gustavmpettersson/StepperPlatform/README.md

# StepperPlatform

This project considers a platform for moving microscopy samples. It is made as a Bachelor's thesis project at KTH. Usage instructions, drawings, and parts can be found in appendices.pdf

Contact me at gupet@kth.se or gustavpettersson@live.com
