gustavmpettersson/StepperPlatform/Drawings/base plate.png

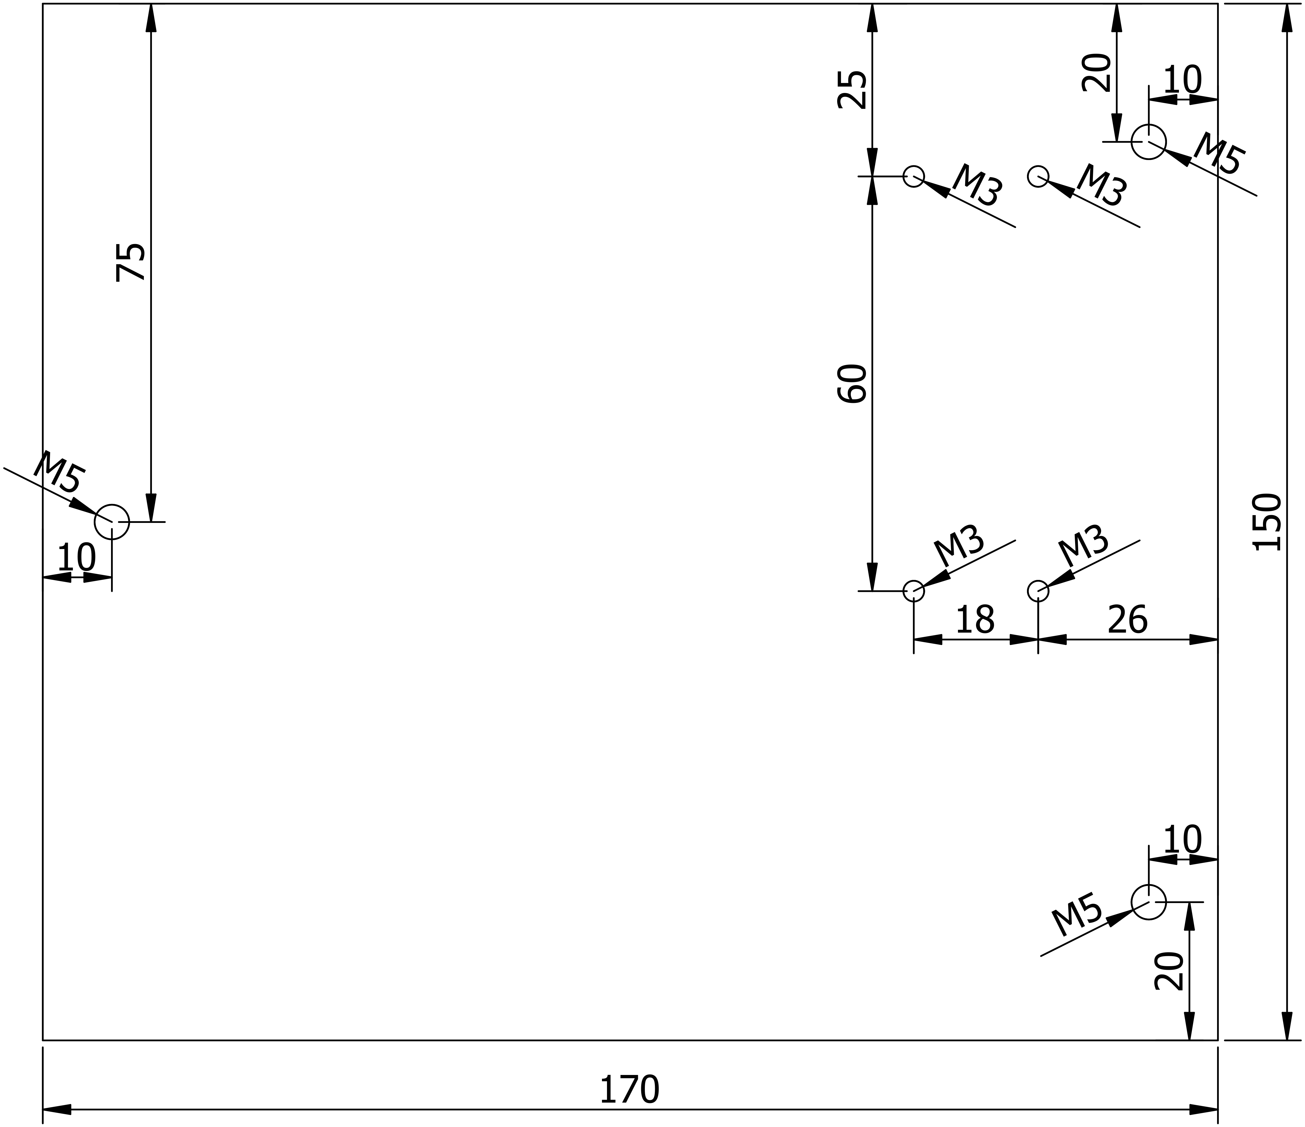
Drawings/base plate.png
