gustavmpettersson/StepperPlatform/Drawings/switch bracket.png

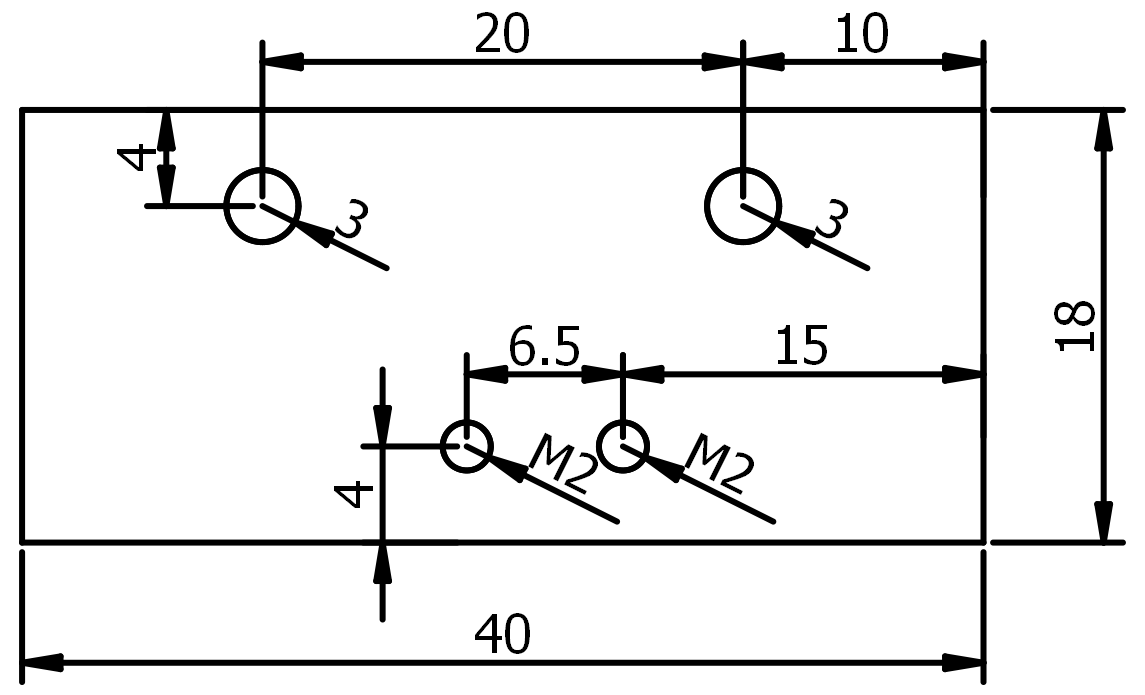
Drawings/switch bracket.png
