gustavmpettersson/StepperPlatform/Drawings/switch bracket.dxf

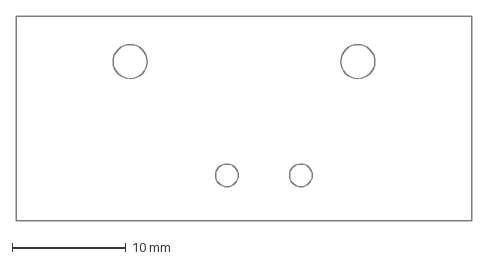
[picture p6: CAD file, 2016-05-02]
Drawings/switch bracket.dxf
40.0 x 18.0 mm
