gustavmpettersson/StepperPlatform/Drawings/base plate.dxf

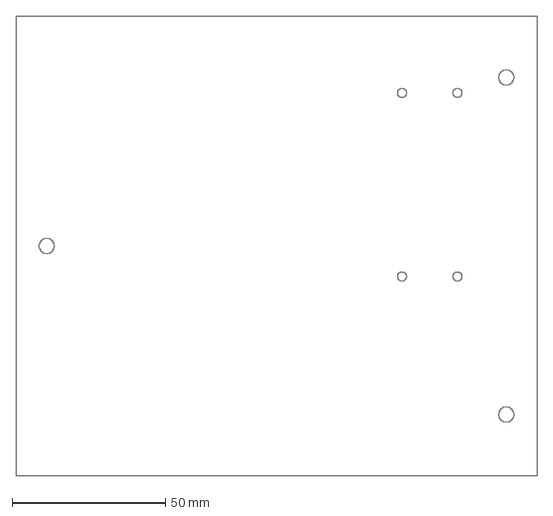
[picture p7: CAD file, 2016-05-02]
Drawings/base plate.dxf
170.0 x 150.0 mm
