gustavmpettersson/StepperPlatform/Drawings/middle bracket.dxf

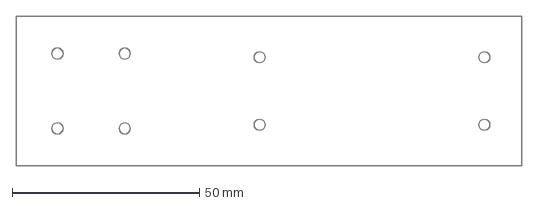
[picture p8: CAD file, 2016-05-02]
Drawings/middle bracket.dxf
135.0 x 40.0 mm
