gustavmpettersson/StepperPlatform/Drawings/sample holder.dxf

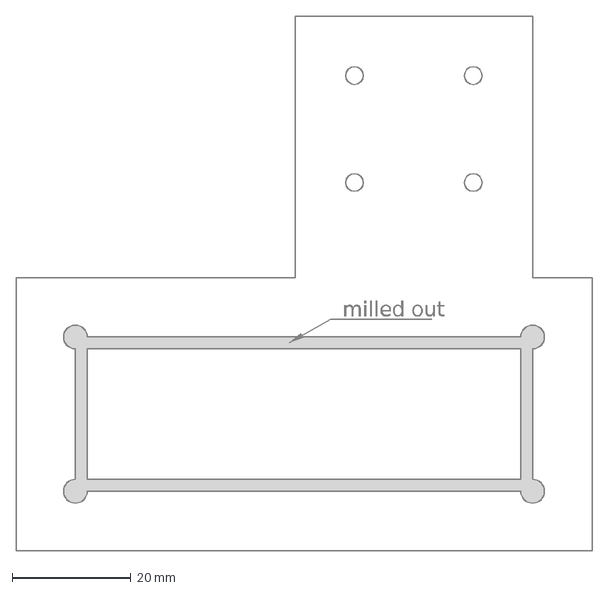
[picture p9: CAD file, 2016-05-02]
Drawings/sample holder.dxf
milled out
