gustavmpettersson/StepperPlatform/Board/KEX V1.brd

## EAGLE design Board/KEX V1.brd (2016-04-30)

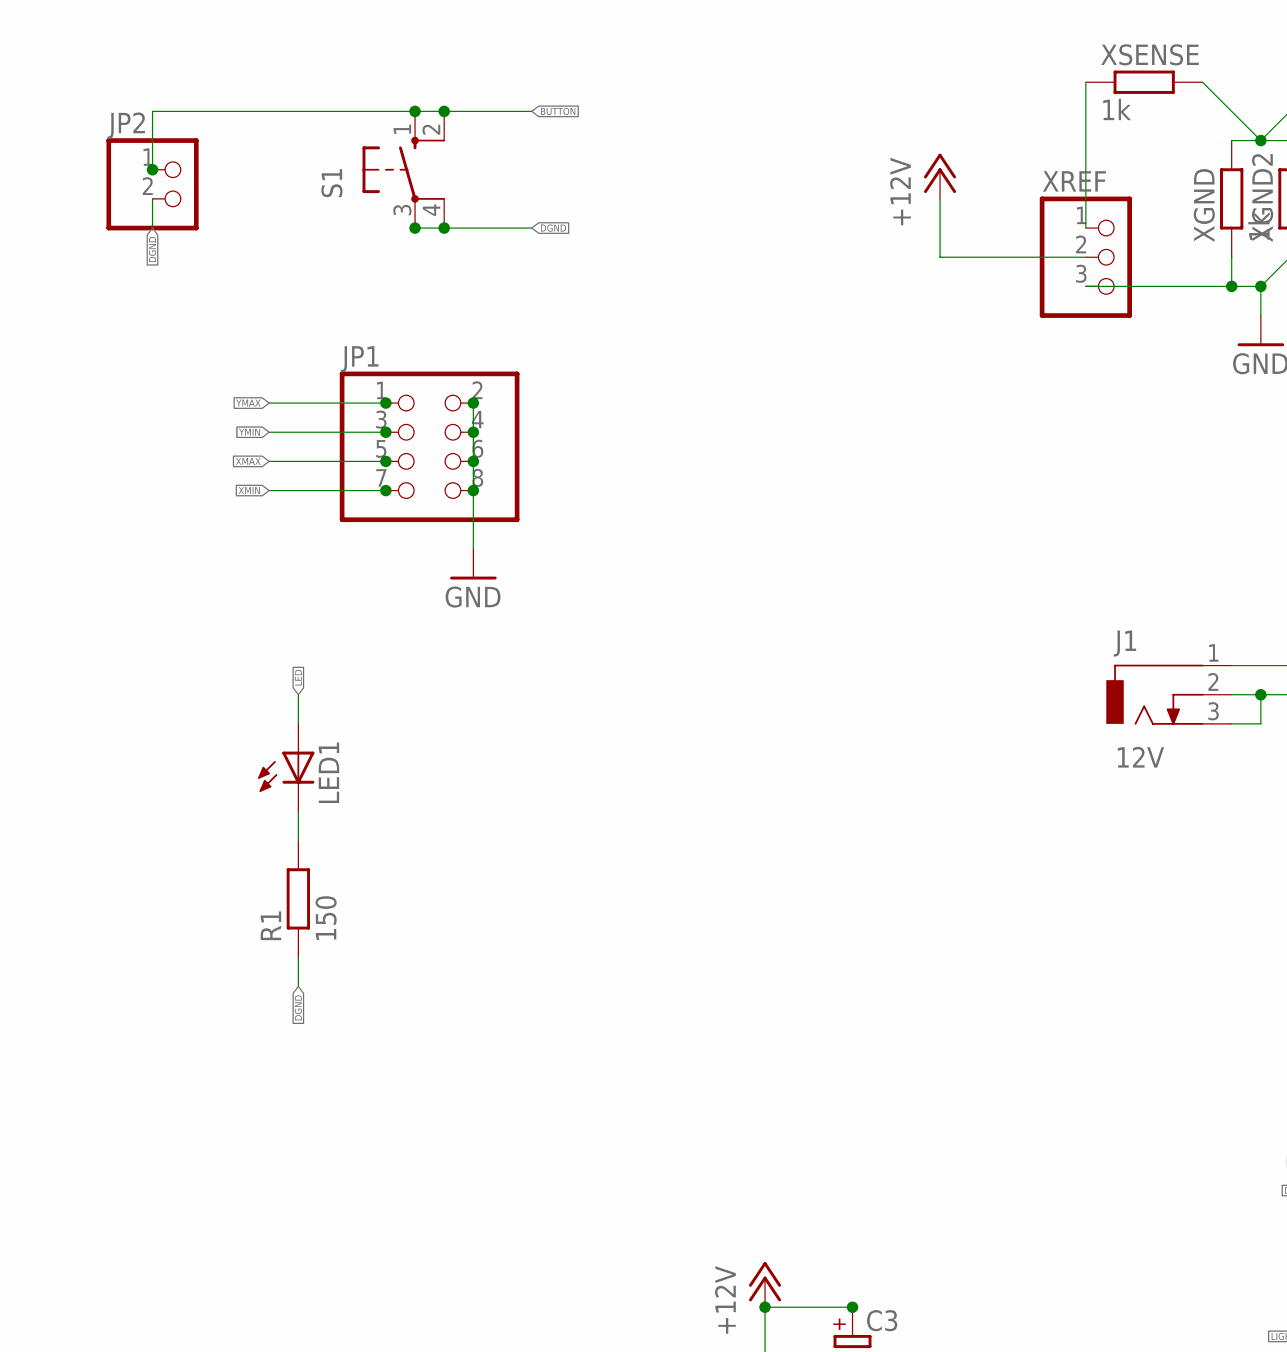
[picture p10: schematic KEX V1.sch, part in row 1, column 1]

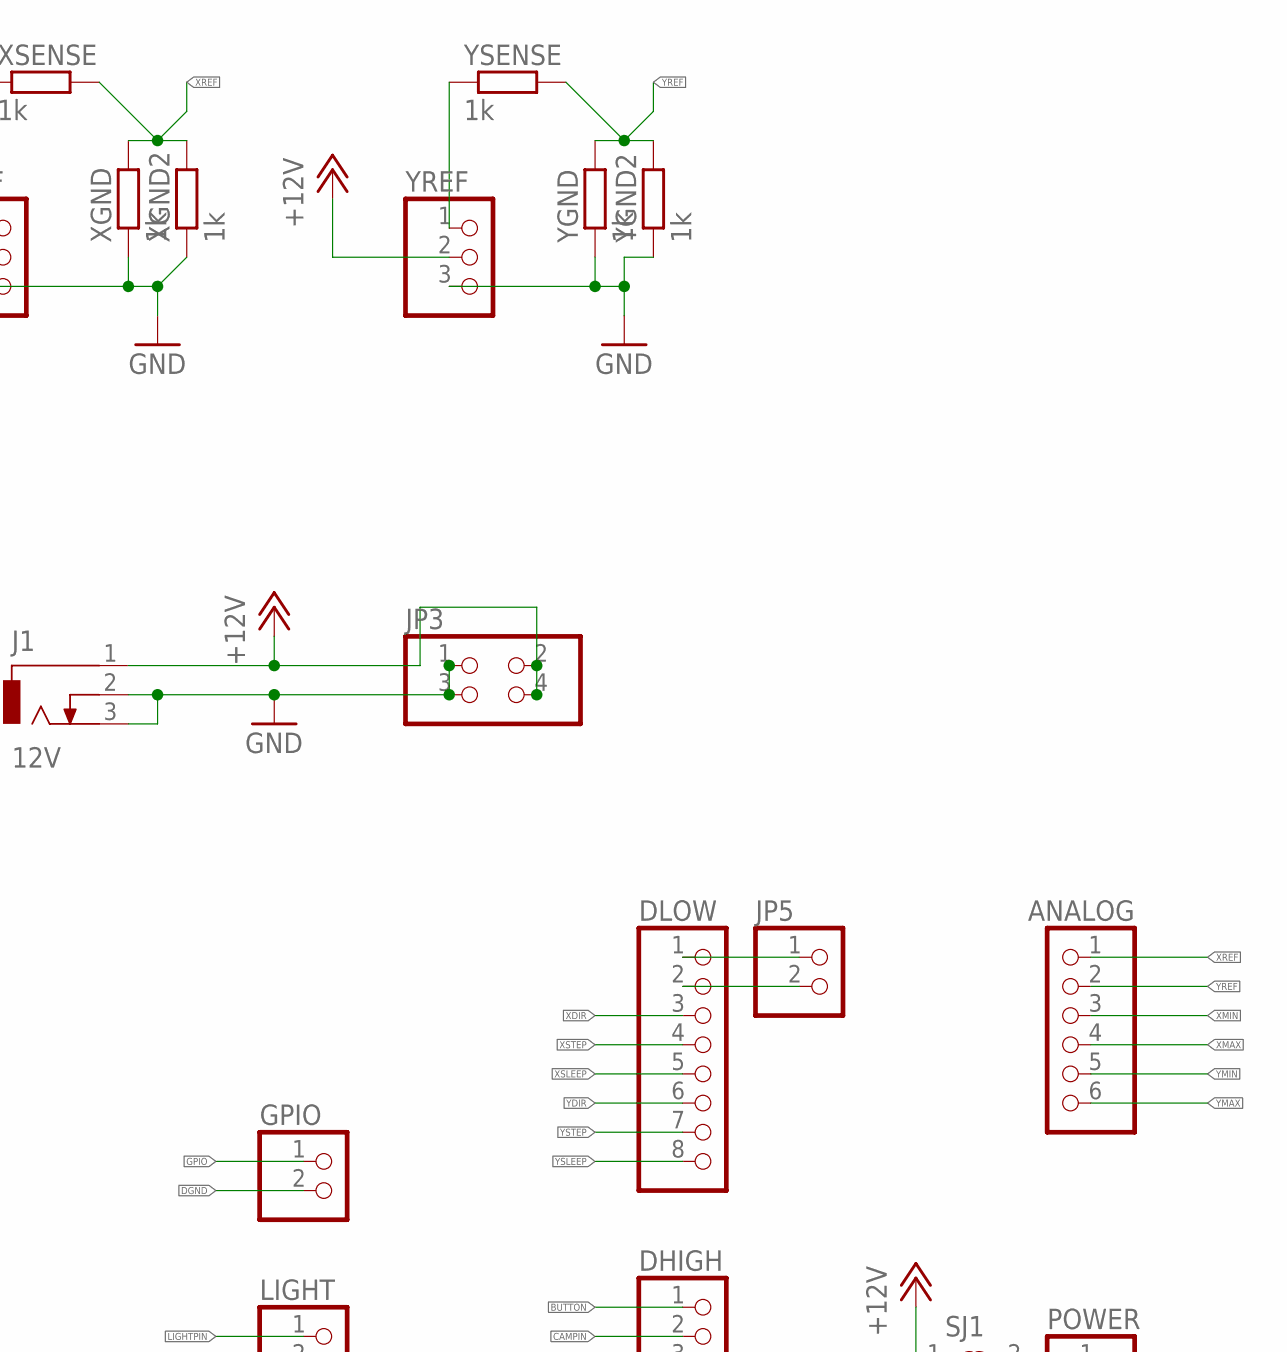
[picture p11: schematic KEX V1.sch, part in row 1, column 2]

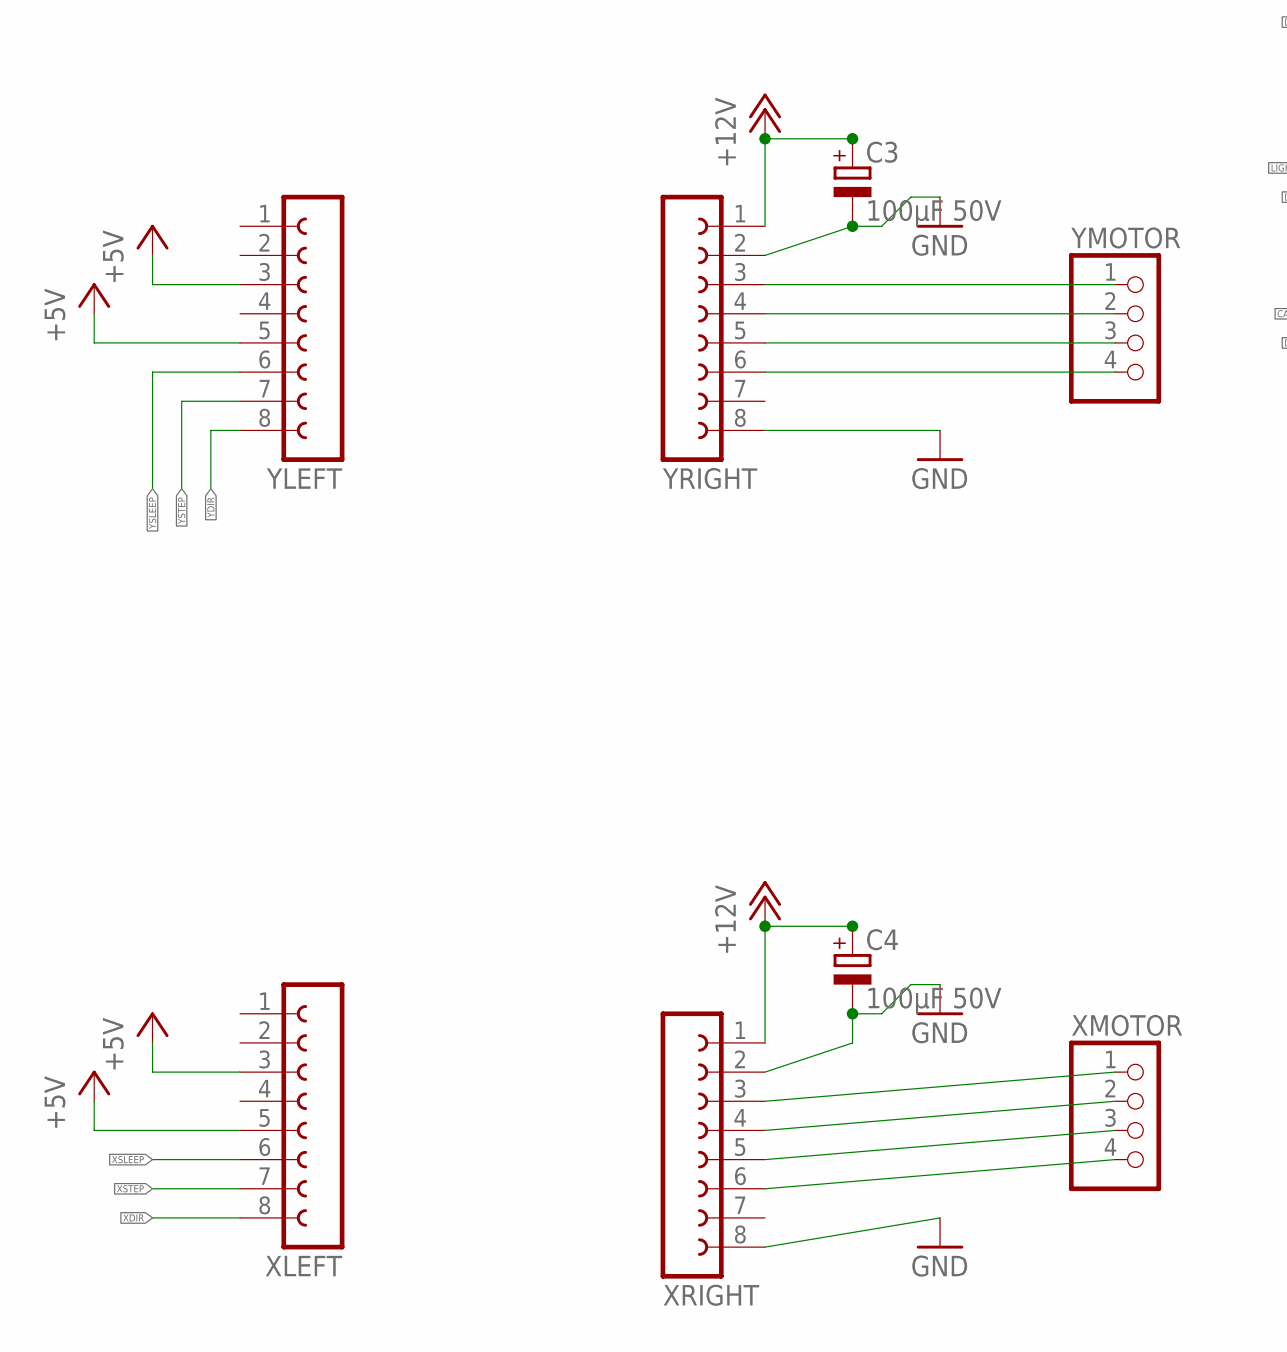
[picture p12: schematic KEX V1.sch, part in row 2, column 1]

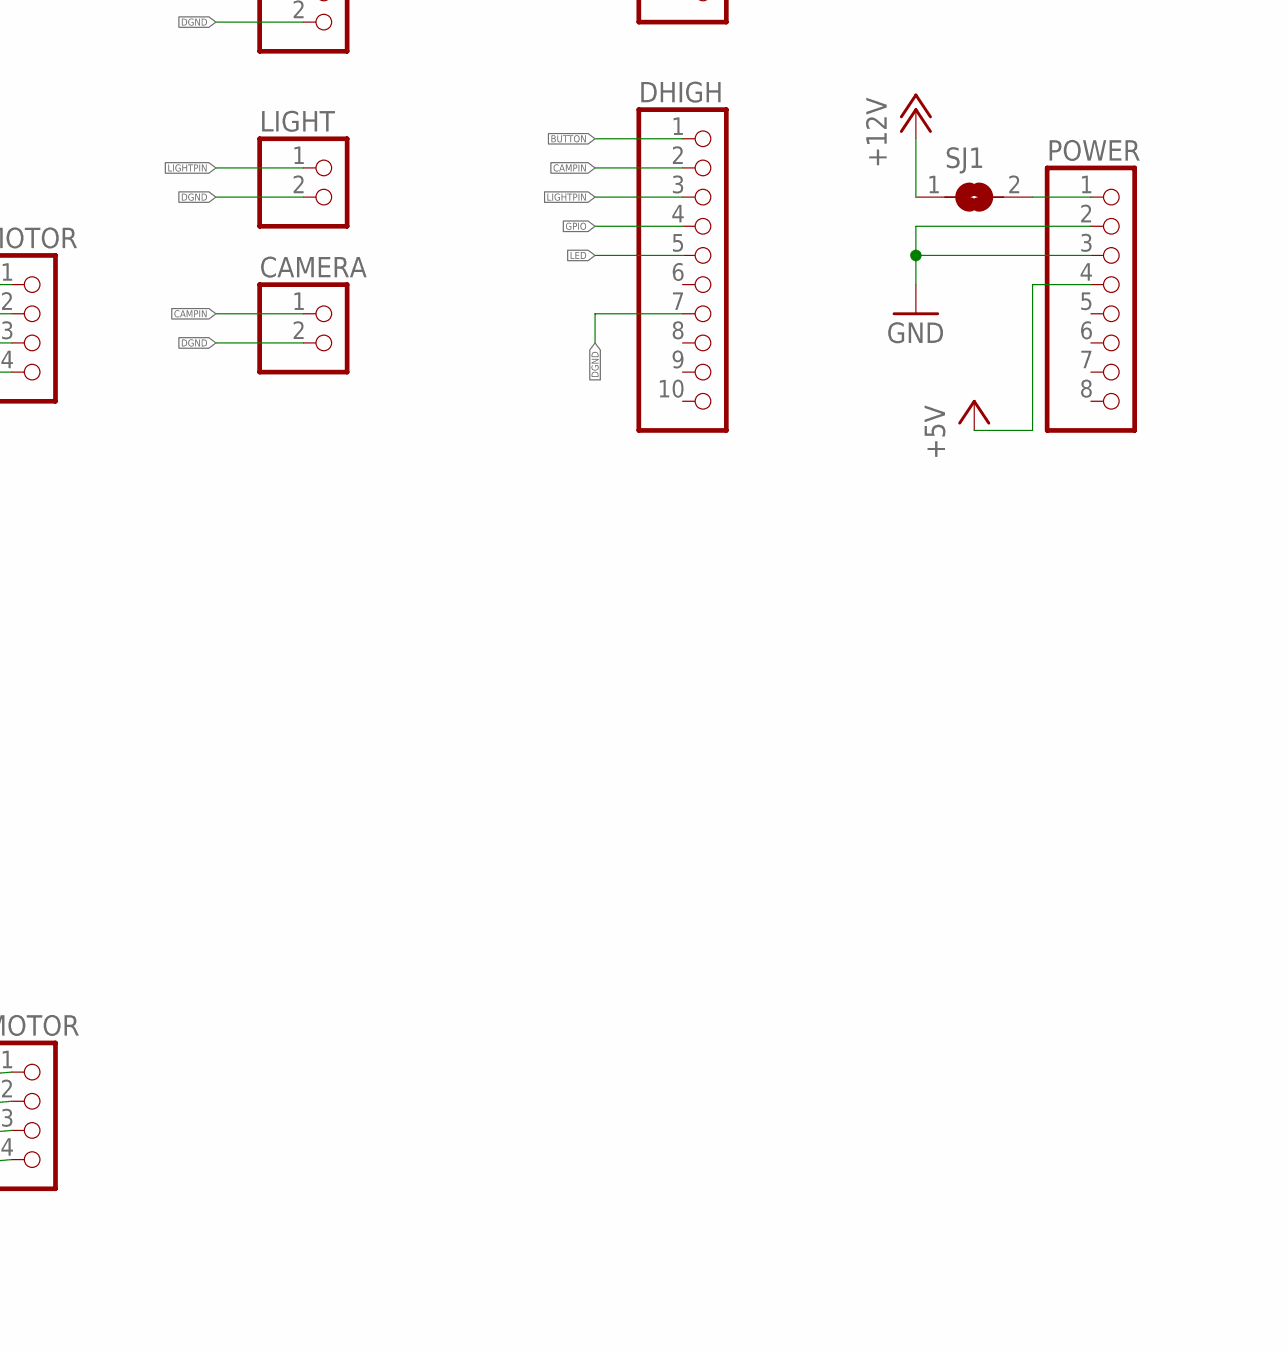
[picture p13: schematic KEX V1.sch, part in row 2, column 2]

Parts:
ANALOG: PINHD-1X6; 1X06
C3, C4: 100µF 50V; E3,5-8
CAMERA: PINHD-1X2; 1X02
DHIGH: PINHD-1X10; 1X10
DLOW: PINHD-1X8; 1X08
GPIO: PINHD-1X2; 1X02
J1: 12V; DCJ0303
JP1: PINHD-2X4; 2X04
JP2, JP5: PINHD-1X2; 1X02
JP3: PINHD-2X2; 2X02
LED1: LED5MM
LIGHT: PINHD-1X2; 1X02
POWER: PINHD-1X8; 1X08
R1: 150; 0204/7
S1: 10-XX; B3F-10XX
SJ1: SJ
XGND, XGND2: 1k; 0204/7
XLEFT: FE08-1; FE08
XMOTOR: PINHD-1X4; 1X04
XREF: PINHD-1X3; 1X03
XRIGHT: FE08-1; FE08
XSENSE: 1k; 0204/7
YGND, YGND2: 1k; 0204/7
YLEFT: FE08-1; FE08
YMOTOR: PINHD-1X4; 1X04
YREF: PINHD-1X3; 1X03
YRIGHT: FE08-1; FE08
YSENSE: 1k; 0204/7

Connections:
+5V: POWER.4, XLEFT.3, XLEFT.5, YLEFT.3, YLEFT.5
+12V: C3.+, C4.+, J1.1, JP3.2, JP3.4, SJ1.1, XREF.2, XRIGHT.1, YREF.2, YRIGHT.1
BUTTON: DHIGH.1, JP2.1, S1.1 (S), S1.2 (S1)
CAMPIN: CAMERA.1, DHIGH.2
DGND: CAMERA.2, DHIGH.7, GPIO.2, JP2.2, LIGHT.2, R1.1, S1.3, S1.4 (P1)
GND: C3.-, C4.-, J1.2, J1.3, JP1.2, JP1.4, JP1.6, JP1.8, JP3.1, JP3.3, POWER.2, POWER.3, XGND.1, XGND2.1, XREF.3, XRIGHT.2, XRIGHT.8, YGND.1, YGND2.1, YREF.3, YRIGHT.2, YRIGHT.8
GPIO: DHIGH.4, GPIO.1
LED: DHIGH.5, LED1.A
LIGHTPIN: DHIGH.3, LIGHT.1
unnamed: XMOTOR.1, XRIGHT.3
unnamed: XMOTOR.2, XRIGHT.4
unnamed: XMOTOR.3, XRIGHT.5
unnamed: XMOTOR.4, XRIGHT.6
unnamed: DLOW.1, JP5.1
unnamed: DLOW.2, JP5.2
unnamed: YMOTOR.1, YRIGHT.3
unnamed: YMOTOR.2, YRIGHT.4
unnamed: YMOTOR.3, YRIGHT.5
unnamed: YMOTOR.4, YRIGHT.6
unnamed: LED1.K (C), R1.2
unnamed: POWER.1, SJ1.2
unnamed: XREF.1, XSENSE.1
unnamed: YREF.1, YSENSE.1
XDIR: DLOW.3, XLEFT.8
XMAX: ANALOG.4, JP1.5
XMIN: ANALOG.3, JP1.7
XREF: ANALOG.1, XGND.2, XGND2.2, XSENSE.2
XSLEEP: DLOW.5, XLEFT.6
XSTEP: DLOW.4, XLEFT.7
YDIR: DLOW.6, YLEFT.8
YMAX: ANALOG.6, JP1.1
YMIN: ANALOG.5, JP1.3
YREF: ANALOG.2, YGND.2, YGND2.2, YSENSE.2
YSLEEP: DLOW.8, YLEFT.6
YSTEP: DLOW.7, YLEFT.7

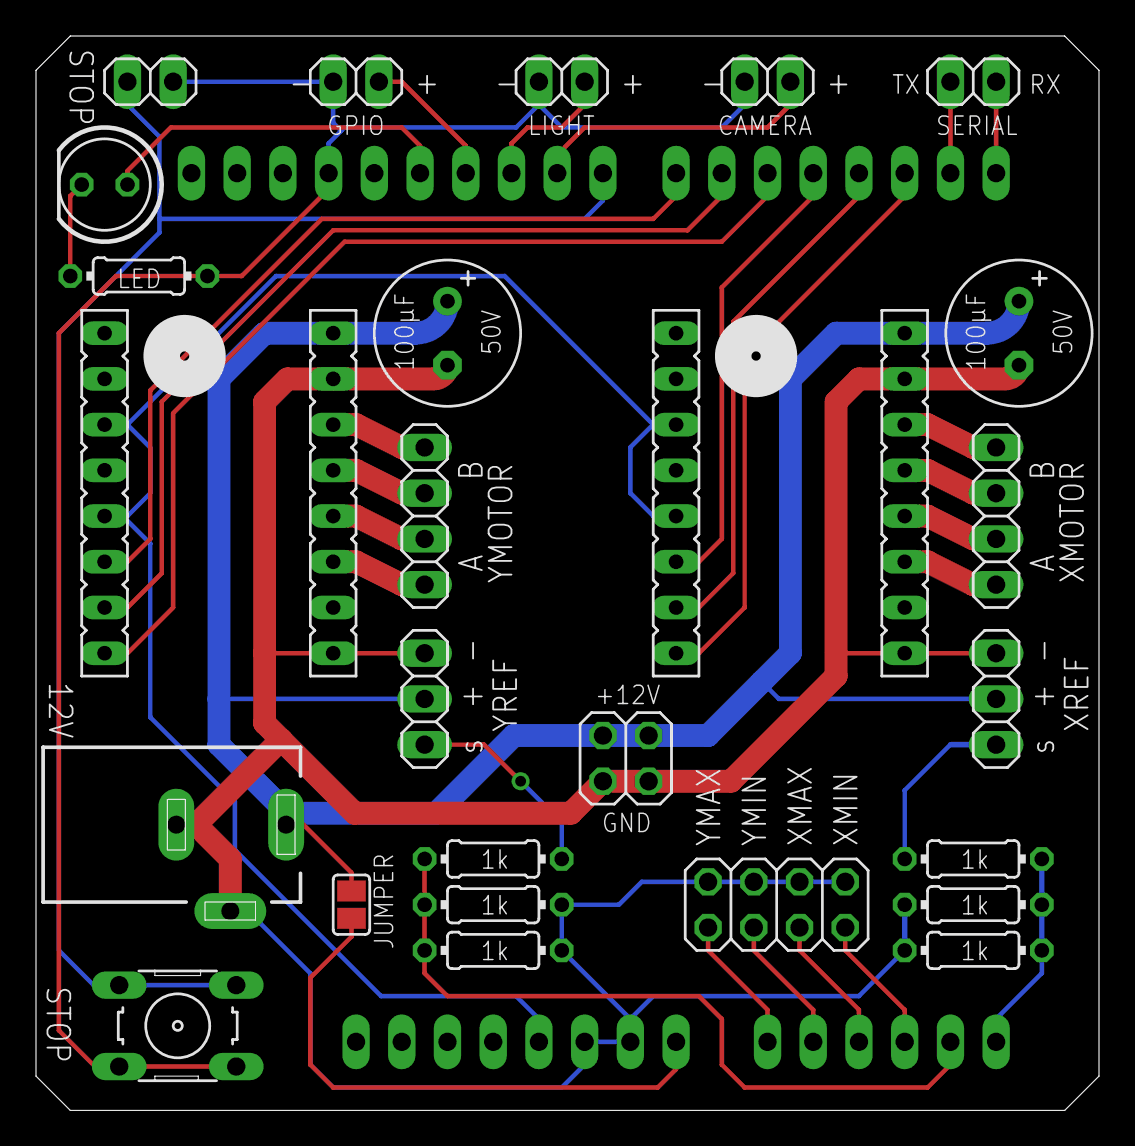
[picture p14: board KEX V1.brd from above]

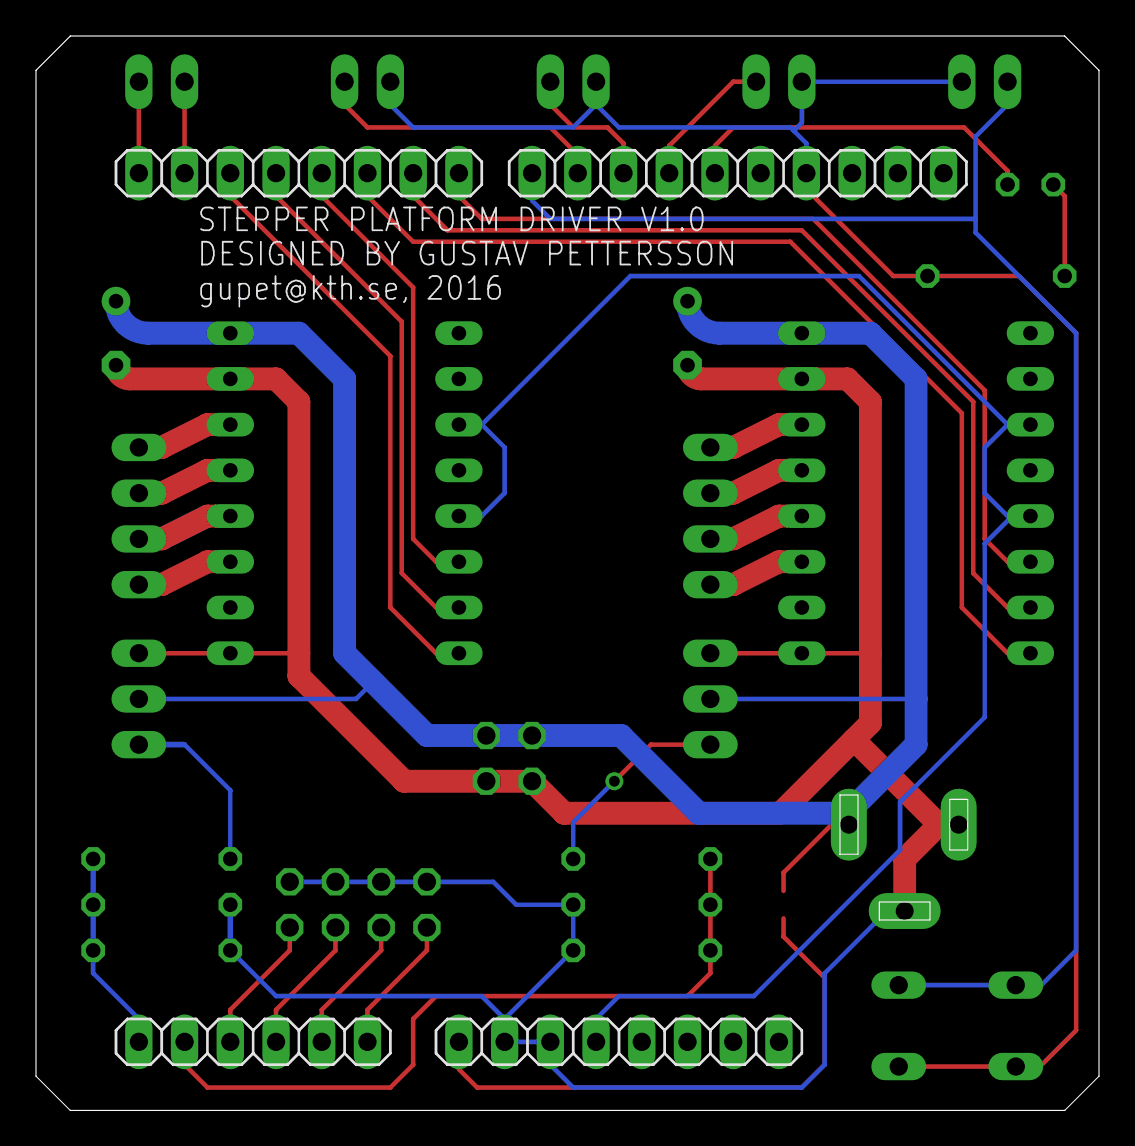
[picture p15: board KEX V1.brd from below]

Board: 2 copper layers, 59.1 x 59.7 mm, 32 parts (4 on the bottom side), 35 nets.
