gustavmpettersson/StepperPlatform/PlatformSketch/BoardSetup_V1_0.cpp

#define xDirPin 2 //Direction pin for x
#define xStepPin 3 //Step pin for x
#define xSleepPin 4 //Sleep pin for x
#define yDirPin 5 //Direction pin for y
#define yStepPin 6 //Step pin for y
#define ySleepPin 7 //Sleep pin for y
#define xRefPin A5 //Reference switch for x
#define yRefPin A4 //Reference switch for y
#define xMinPin A3 //Min endstop switch for x
#define xMaxPin A2 //Max endstop switch for x
#define yMinPin A1 //Min endstop switch for y
#define yMaxPin A0 //Max endstop switch for y

#define stopButtonPin 8 //Pin for stop button
#define cameraPin 9 //Pin for camera shutter control
#define lightPin 10 //Pin for sample light control
#define GPIOPin 11 //Not currently in use, but available on board
#define LEDPin 12 //Pin for LED
