gustavmpettersson/StepperPlatform/(commit log)

2016-04-30 Rename KEX V1.sch to Board/KEX V1.sch
    [KEX V1.sch]
2016-04-30 Rename KEX V1.brd to Board/KEX V1.brd
    [KEX V1.brd]
